magao-x/handbook/index.rst

Instrument Handbook
===================================

.. include:: README.rst

Table of contents
=================

.. toctree::
    :maxdepth: 3

    observers/index
    operating/index
    software/index
    testbed/index
    maintenance/index
    troubleshooting
    handling/index
    compute/index
    appendices/index
