magao-x/handbook/observers/planning.rst

******************************
Planning your observations
******************************

.. toctree::
   :maxdepth: 1

   filters
   cameras
   coronagraphs
