magao-x/handbook/observers/reduction/index.rst

Data reduction and calibration
==============================

Information about reducing MagAO-X data.

.. toctree::
   :maxdepth: 2

   astrometry
   sparkles
