magao-x/handbook/maintenance/electronics/index.rst

Electronics
===================================

Procedures and guidelines for maintenance of MagAO-X electronics.

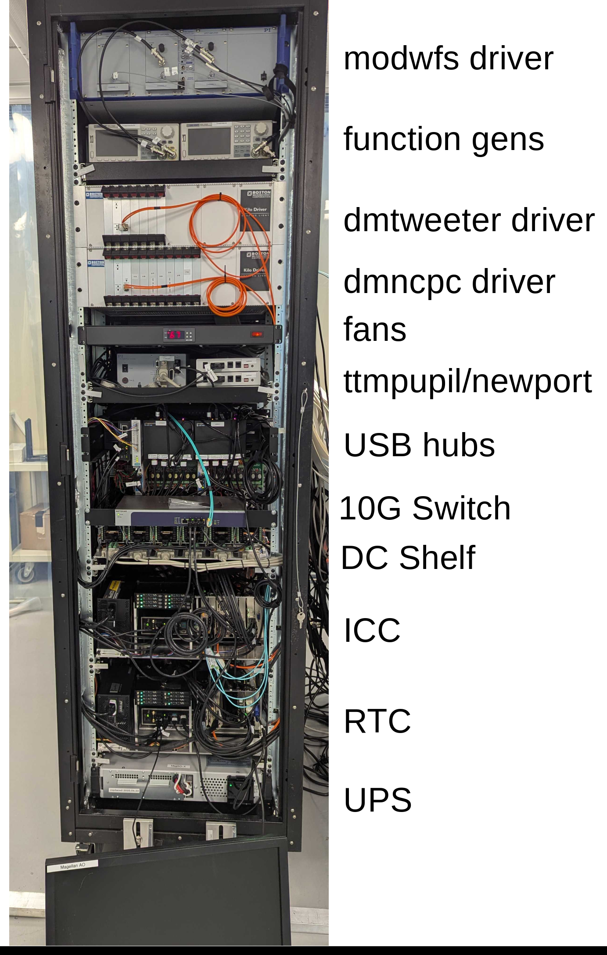
[picture p84: maintenance/electronics/figures/electronics.png]
   

   *The MagAO-X Electronics Rack*

.. toctree::
   :maxdepth: 1

   computers
   zaber_stages
