magao-x/handbook/compute/example_power_gui.png

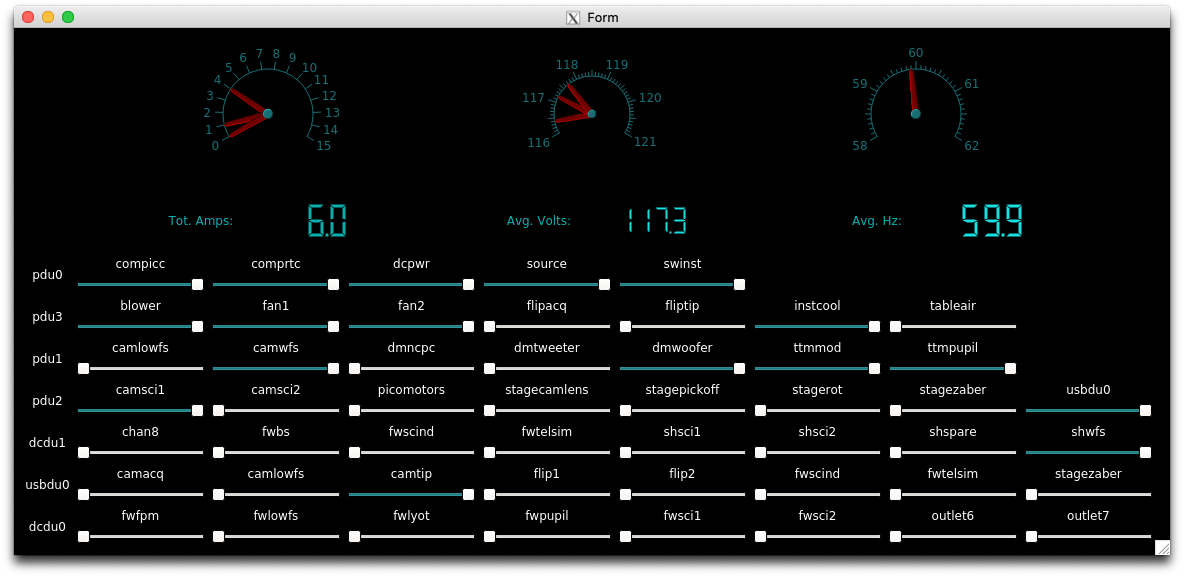
compute/example_power_gui.png
