magao-x/handbook/handling/figures/air_receiver_drier.jpeg

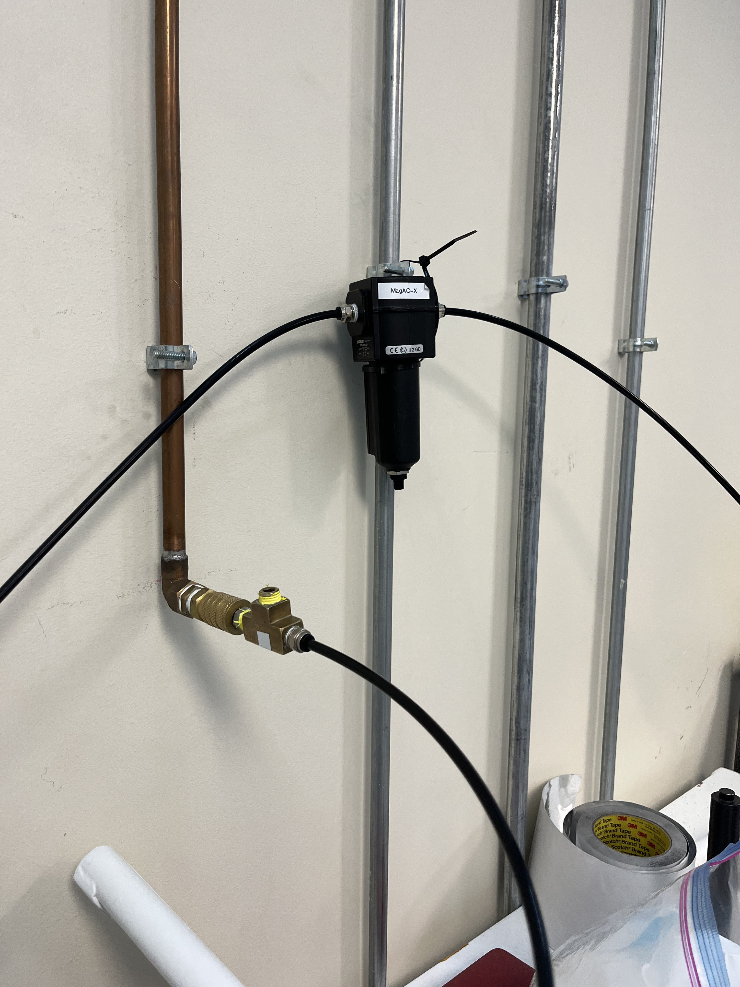
handling/figures/air_receiver_drier.jpeg
