magao-x/handbook/handling/figures/bmc_samtec_insert.jpg

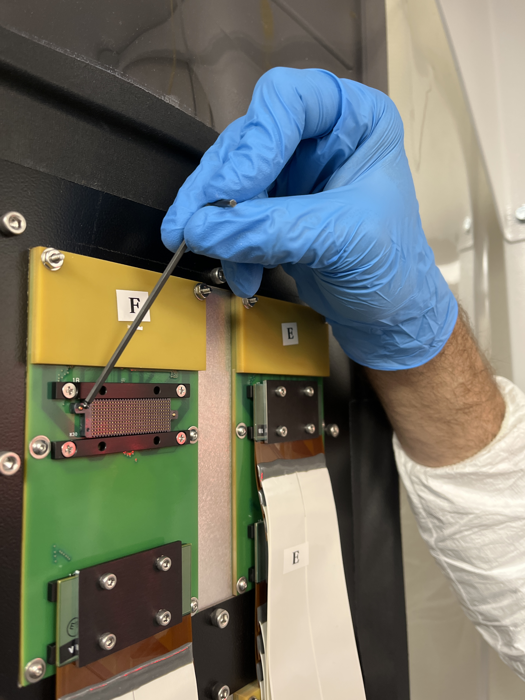
handling/figures/bmc_samtec_insert.jpg
