magao-x/handbook/maintenance/electronics/figures/erack_input_side_open.jpg

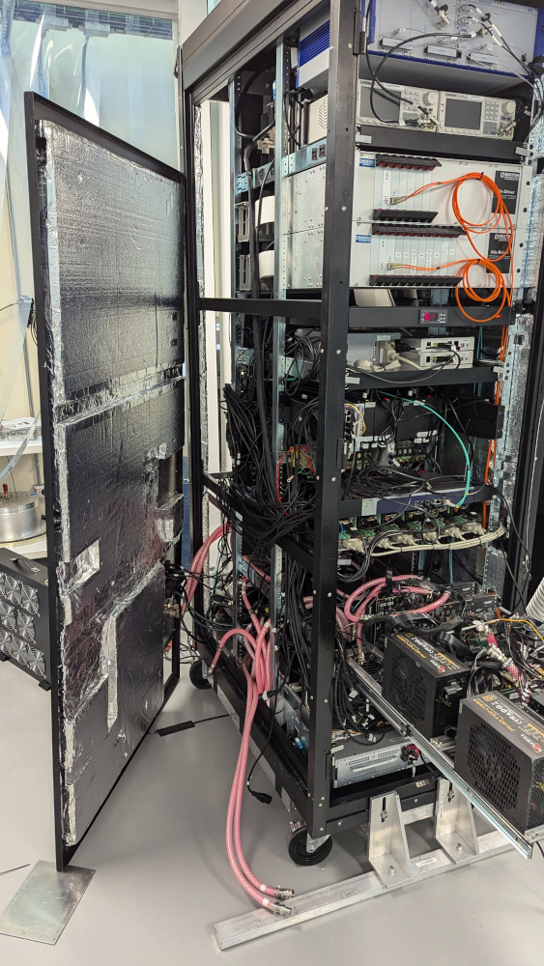
maintenance/electronics/figures/erack_input_side_open.jpg
