magao-x/handbook/handling/figures/air_components_stowed.jpeg

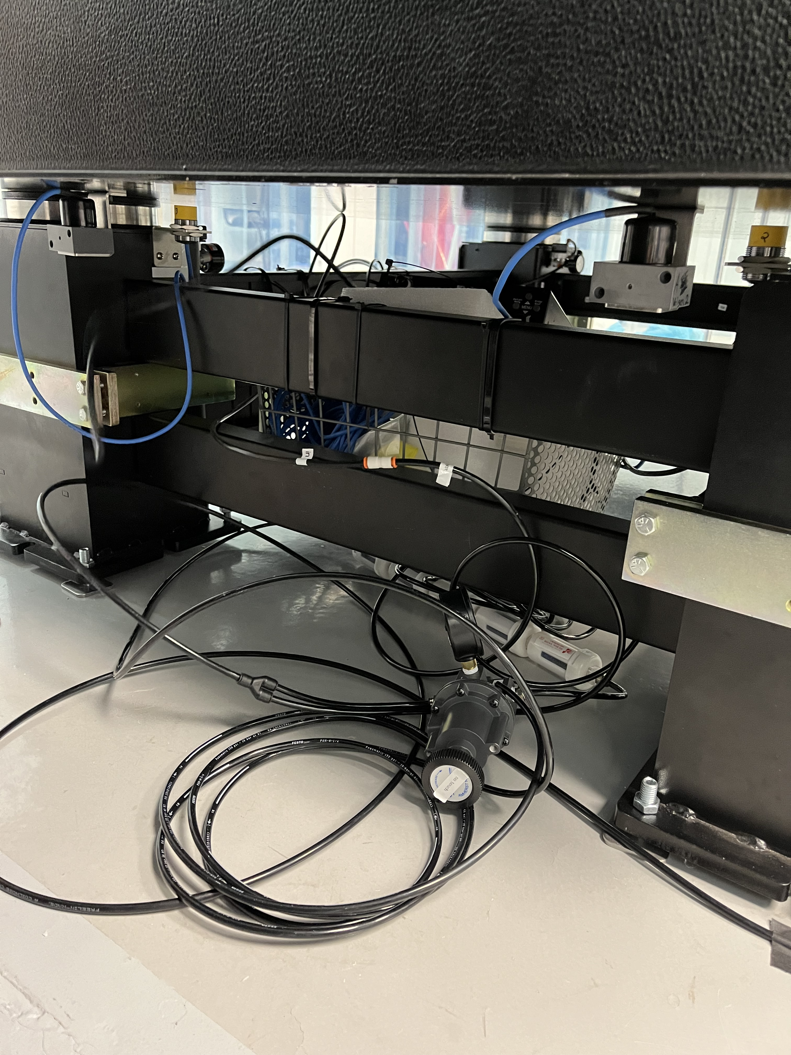
handling/figures/air_components_stowed.jpeg
