magao-x/handbook/handling/figures/components_basket.jpeg

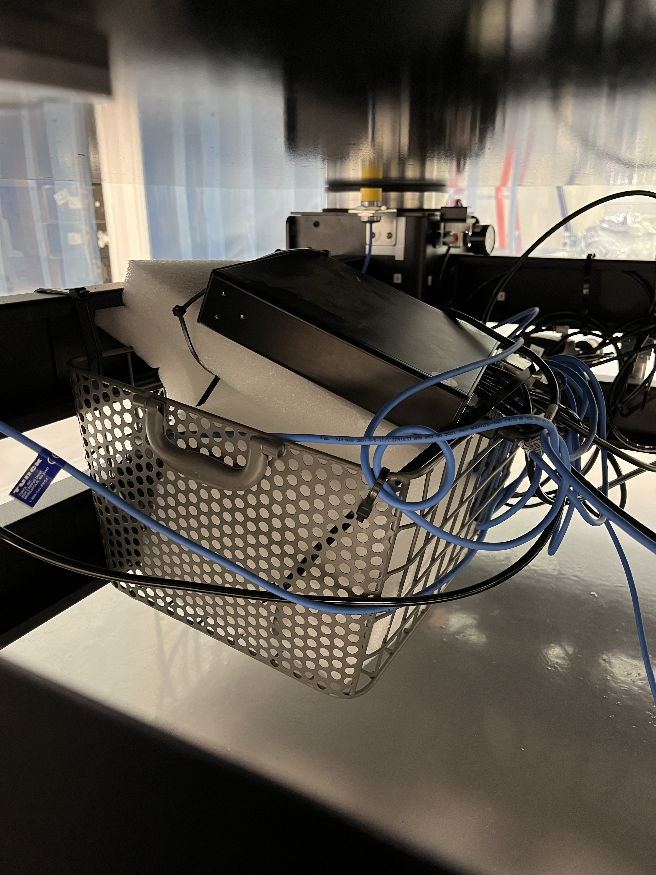
handling/figures/components_basket.jpeg
