magao-x/handbook/_static/coronagraph/lyot/LyotStop_small.DXF

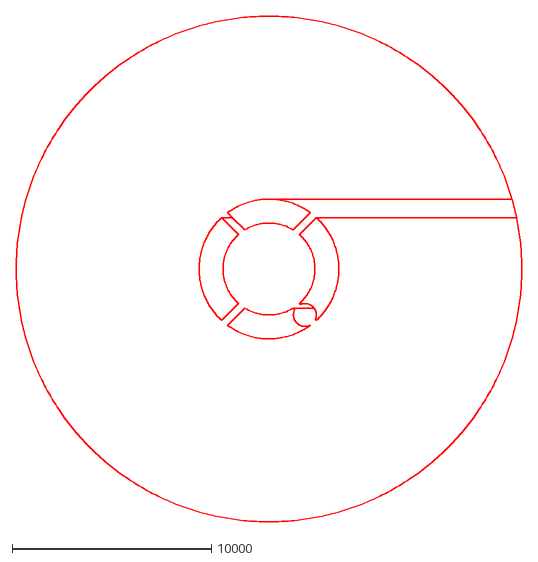
[picture p96: CAD file, 2024-01-09]
_static/coronagraph/lyot/LyotStop_small.DXF
25400.2 x 25400.2
