magao-x/handbook/_static/coronagraph/lyot/LyotStop_large1.DXF

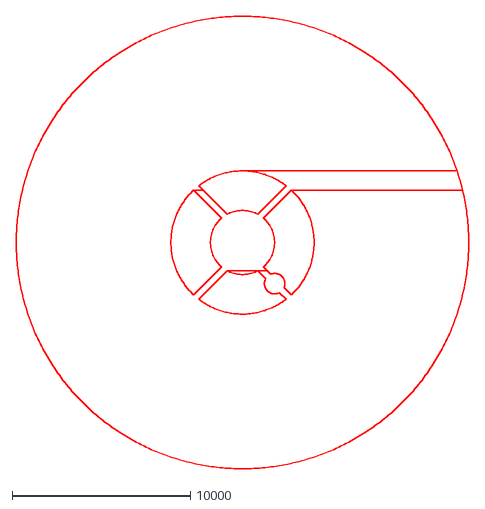
[picture p97: CAD file, 2024-01-09]
_static/coronagraph/lyot/LyotStop_large1.DXF
25400.2 x 25400.2
