magao-x/handbook/_static/coronagraph/lyot/LyotStop_large2.DXF

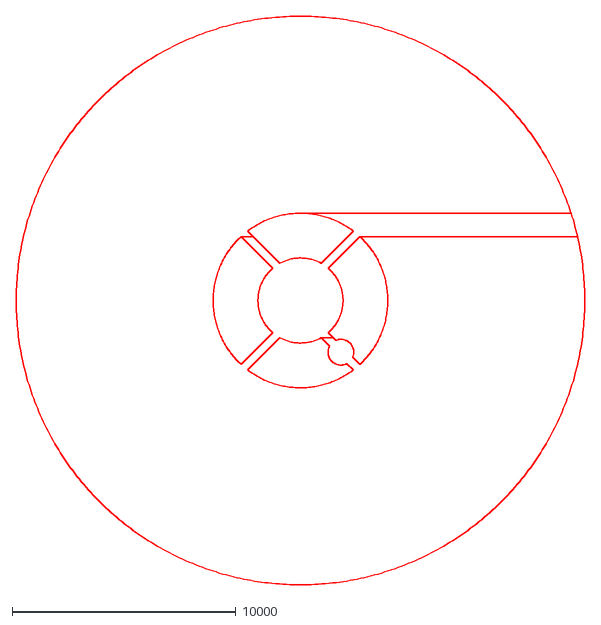
[picture p98: CAD file, 2024-01-09]
_static/coronagraph/lyot/LyotStop_large2.DXF
25400.2 x 25400.2
