magao-x/handbook/operating/block_diagram.rst

Functional Block Diagram
========================

**Updated April 3, 2026**

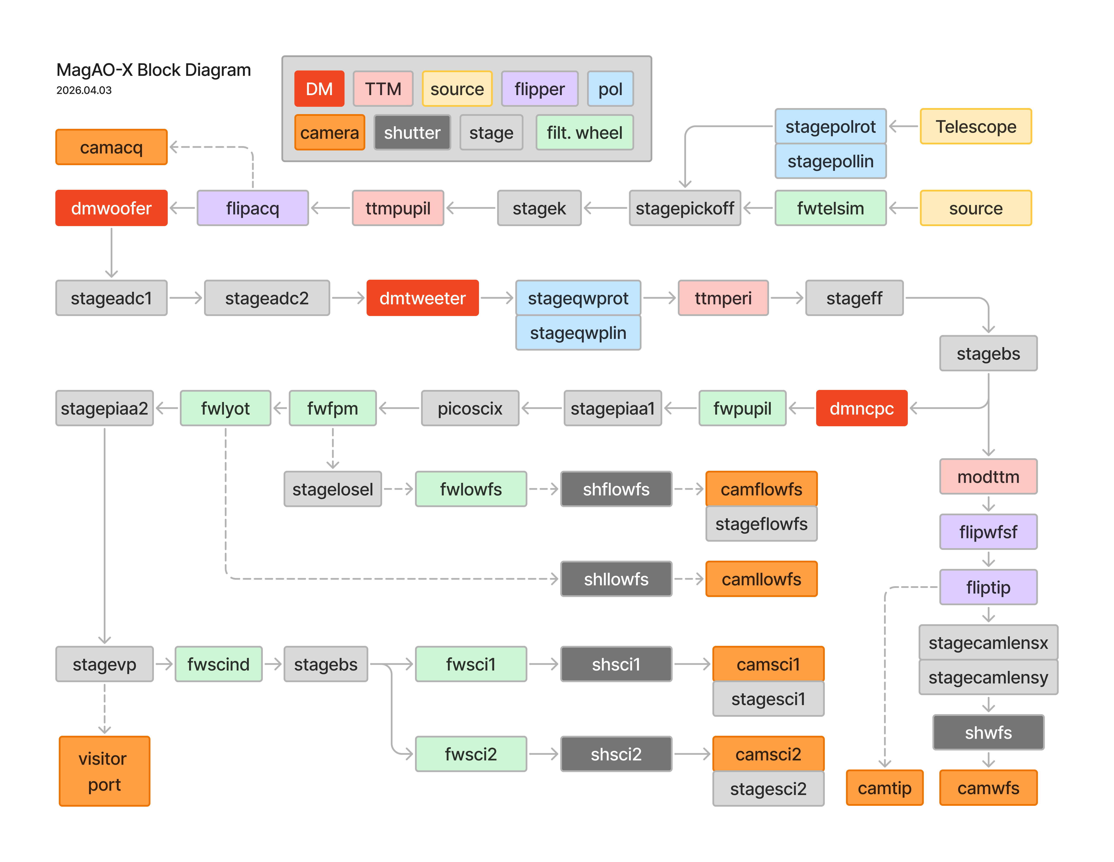
[picture p99: operating/figures/magaox_functionalBlockDiagram_20260403.png]
Block diagram for MagAO-X


Changelog
---------

2026A - update 2026-04-03
^^^^^^^^^^^^^^^^^^^^^^^^^

- Visitor port stage has changed from `visport` to `stagevp`.
- Quarter wave plate rotator `stageqwprot` and linear stage `stageqwplin` installed.
