magao-x/handbook/operating/software/apps/index.rst

Applications
============

.. toctree::
    :maxdepth: 2

    overview
    cameras
    dms
    filters
    zaber
    network
    power
