magao-x/handbook/operating/software/guis/web_gui.rst

Web GUI
========

Open http://localhost:9191/ (or tunnel it to your computer from AOC) to
use the web UI for filter wheels, stage positions, streamwriter and
shutter toggles, etc.
