magao-x/handbook/operating/software/guis/index.rst

GUIs & TUIs
============

.. toctree::
    :maxdepth: 2
    
    cursesINDI
    web_gui
    cameras
