magao-x/handbook/handling/figures/cart_lift_guide_pin.jpg

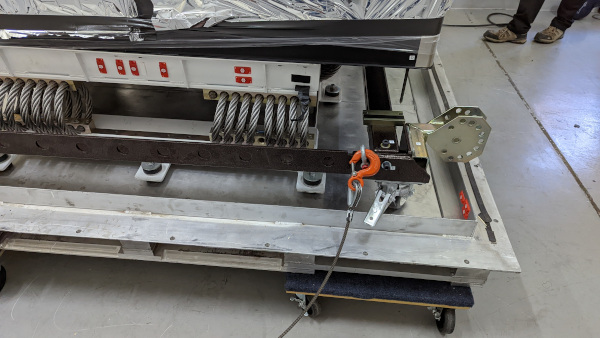
handling/figures/cart_lift_guide_pin.jpg
