magao-x/handbook/operating/bump-mask_aligned.png

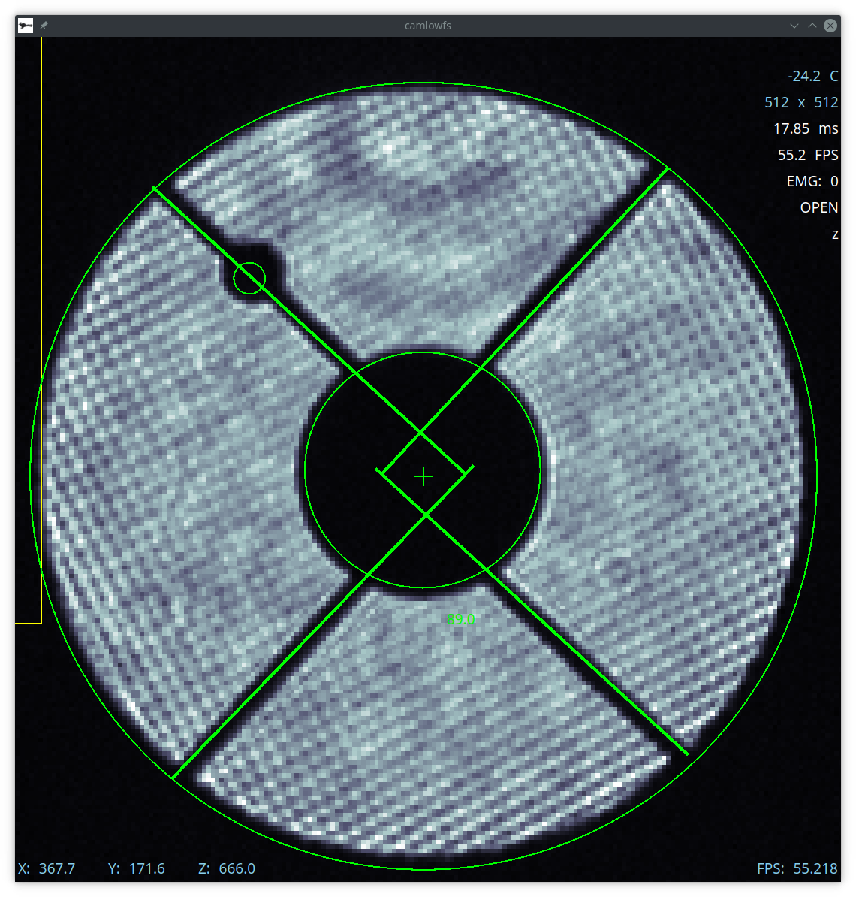
operating/bump-mask_aligned.png
