magao-x/handbook/operating/camlowfs_tgt.png

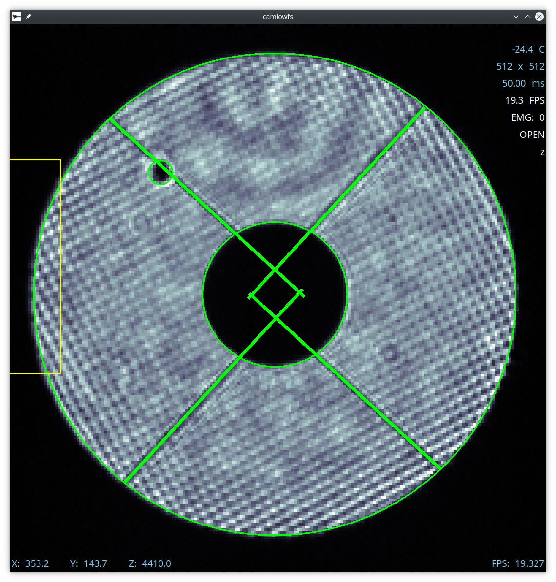
operating/camlowfs_tgt.png
