magao-x/handbook/operating/figures/magaox_functionalBlockDiagram_20251129.png

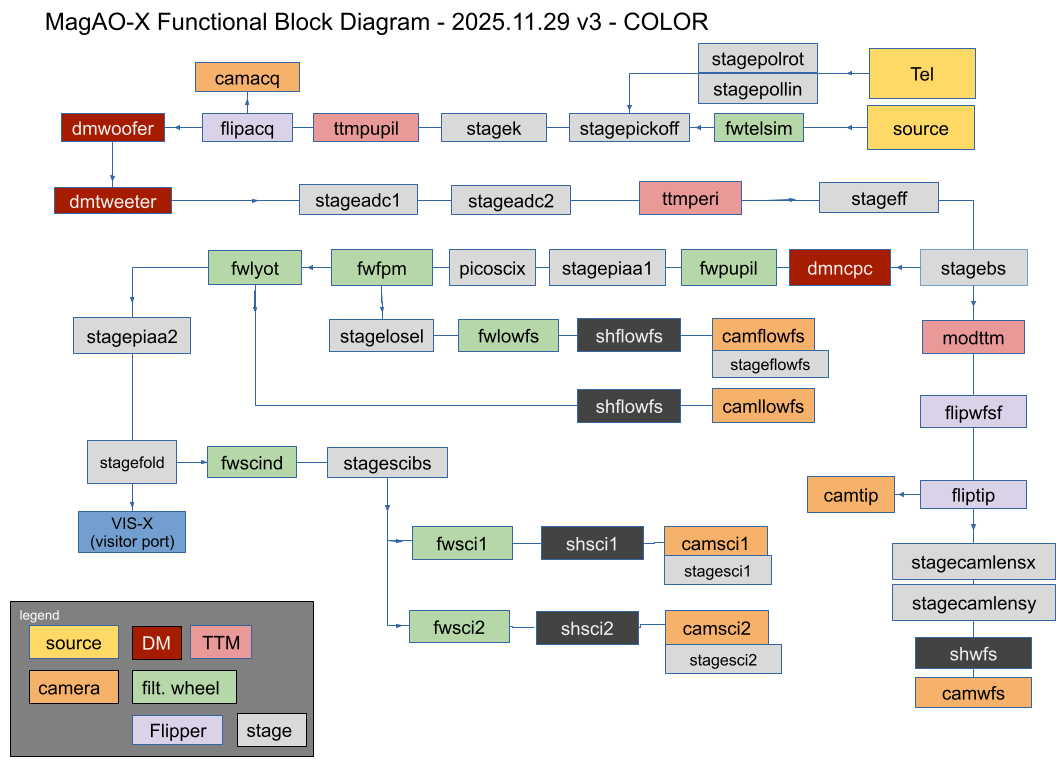
operating/figures/magaox_functionalBlockDiagram_20251129.png
