magao-x/handbook/operating/figures/obslog_start_feed.png

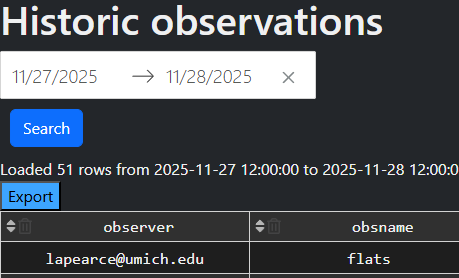
operating/figures/obslog_start_feed.png
