magao-x/handbook/operating/figures/PIAA_Lyot_stop_aligned.png

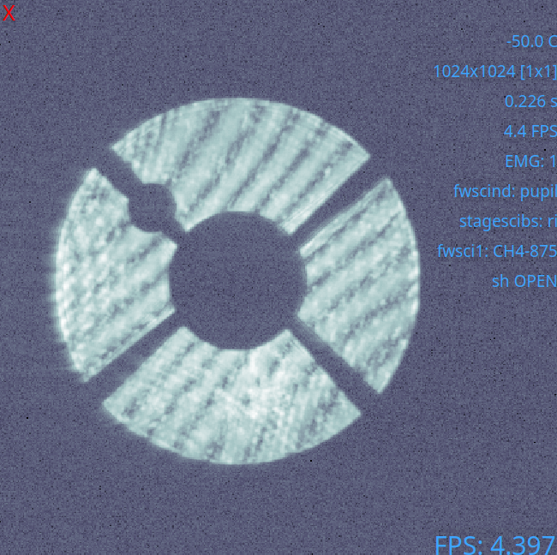
operating/figures/PIAA_Lyot_stop_aligned.png
