magao-x/handbook/operating/fpm_aligned_post_eye-doctor.png

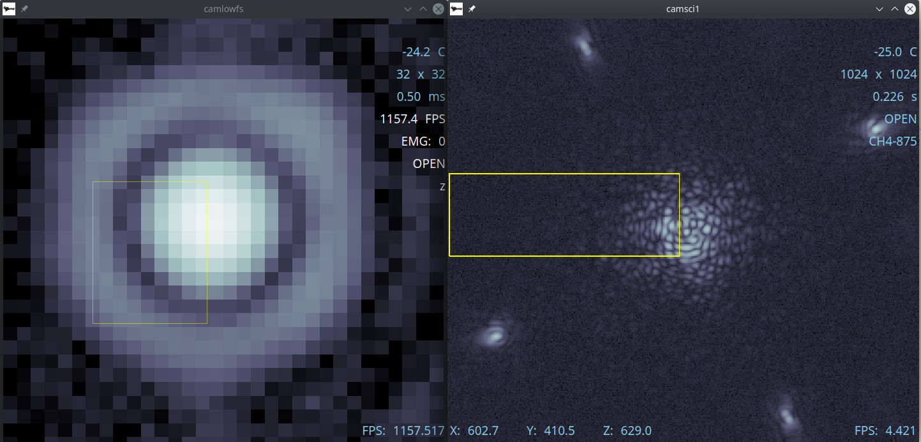
operating/fpm_aligned_post_eye-doctor.png
