magao-x/handbook/operating/fpm_aligned_pre_eye-doctor.png

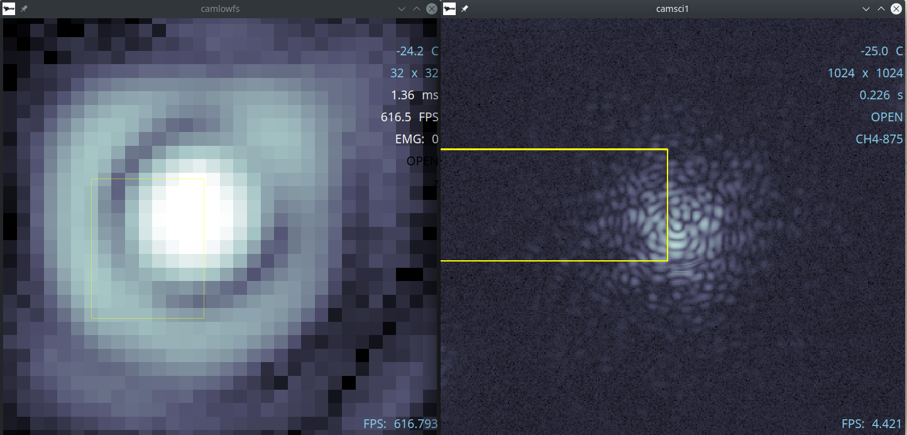
operating/fpm_aligned_pre_eye-doctor.png
