magao-x/handbook/operating/fwlyot_lyotlg1_aligned.png

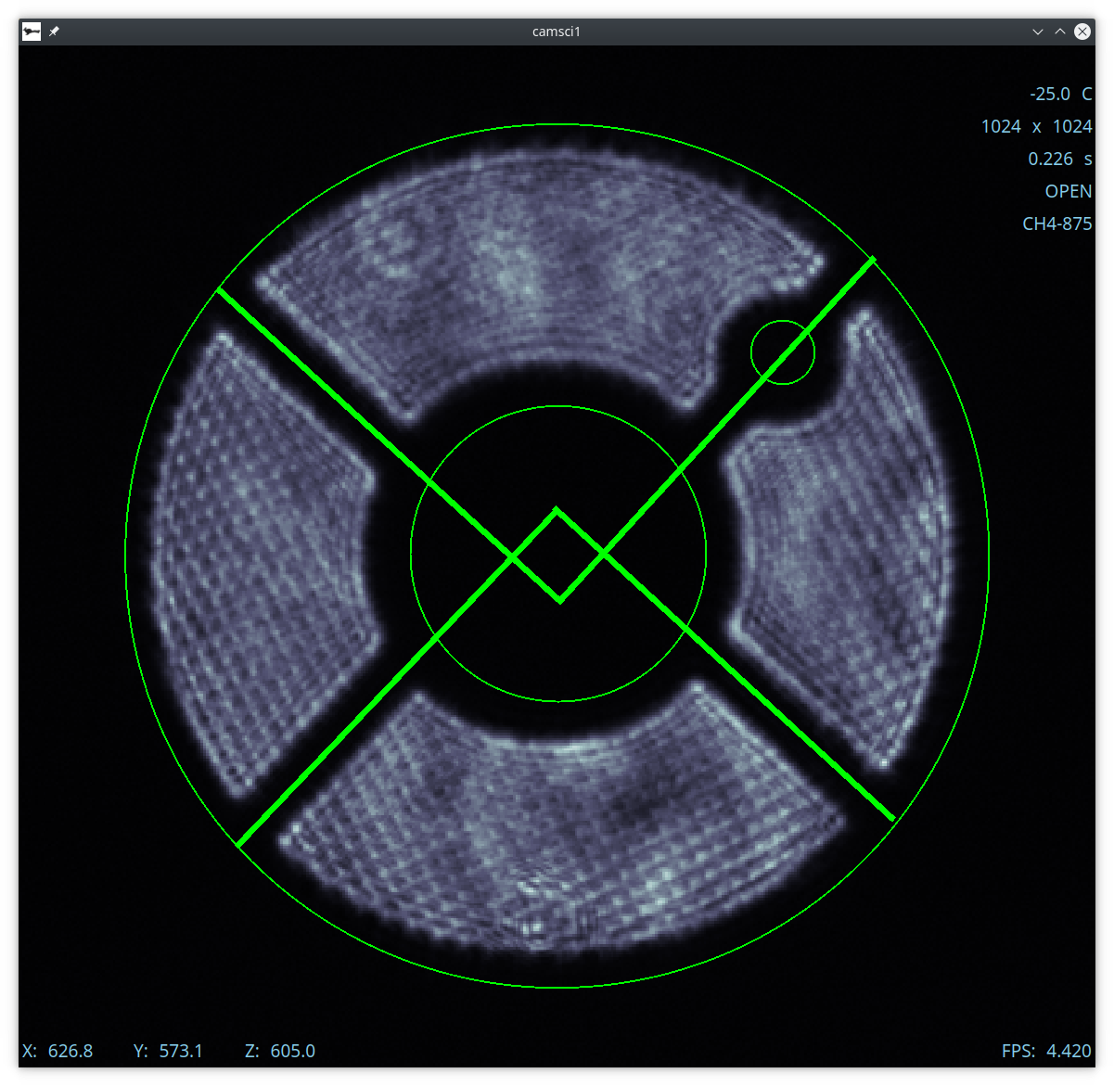
operating/fwlyot_lyotlg1_aligned.png
