magao-x/handbook/operating/rtc_save_and_exit_yes.png

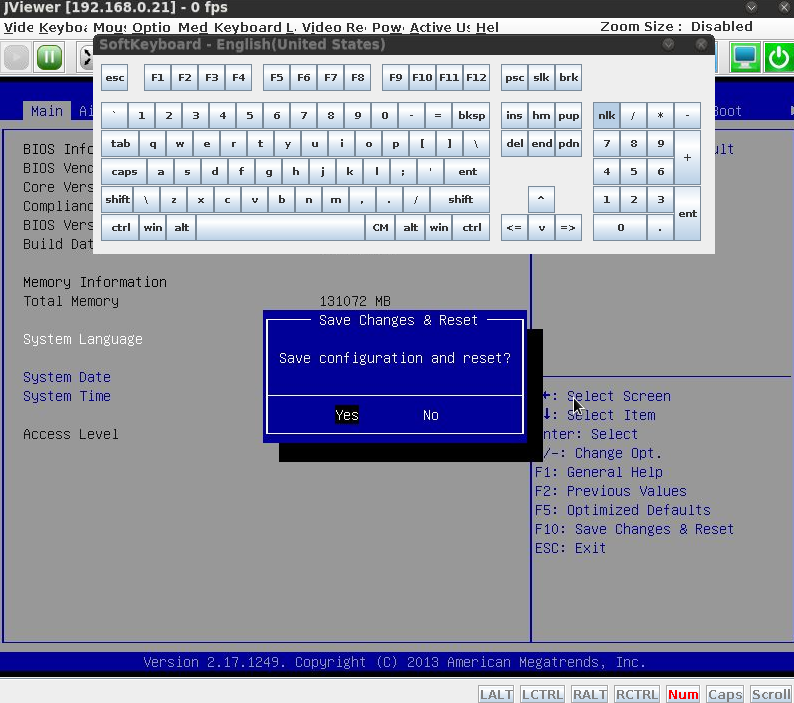
operating/rtc_save_and_exit_yes.png
