magao-x/handbook/maintenance/cooling/measuring_glycol_freezing_point.rst

Measurement of coolant freezing point
==========================================================================

We have and an Extech R41 model refractometer in the MagAO-X "Cooling system parts, tools, and hardware" box in the cleanroom.
It is in a black semi-hardshell case about the size of an eyeglasses case.

Usage
----------

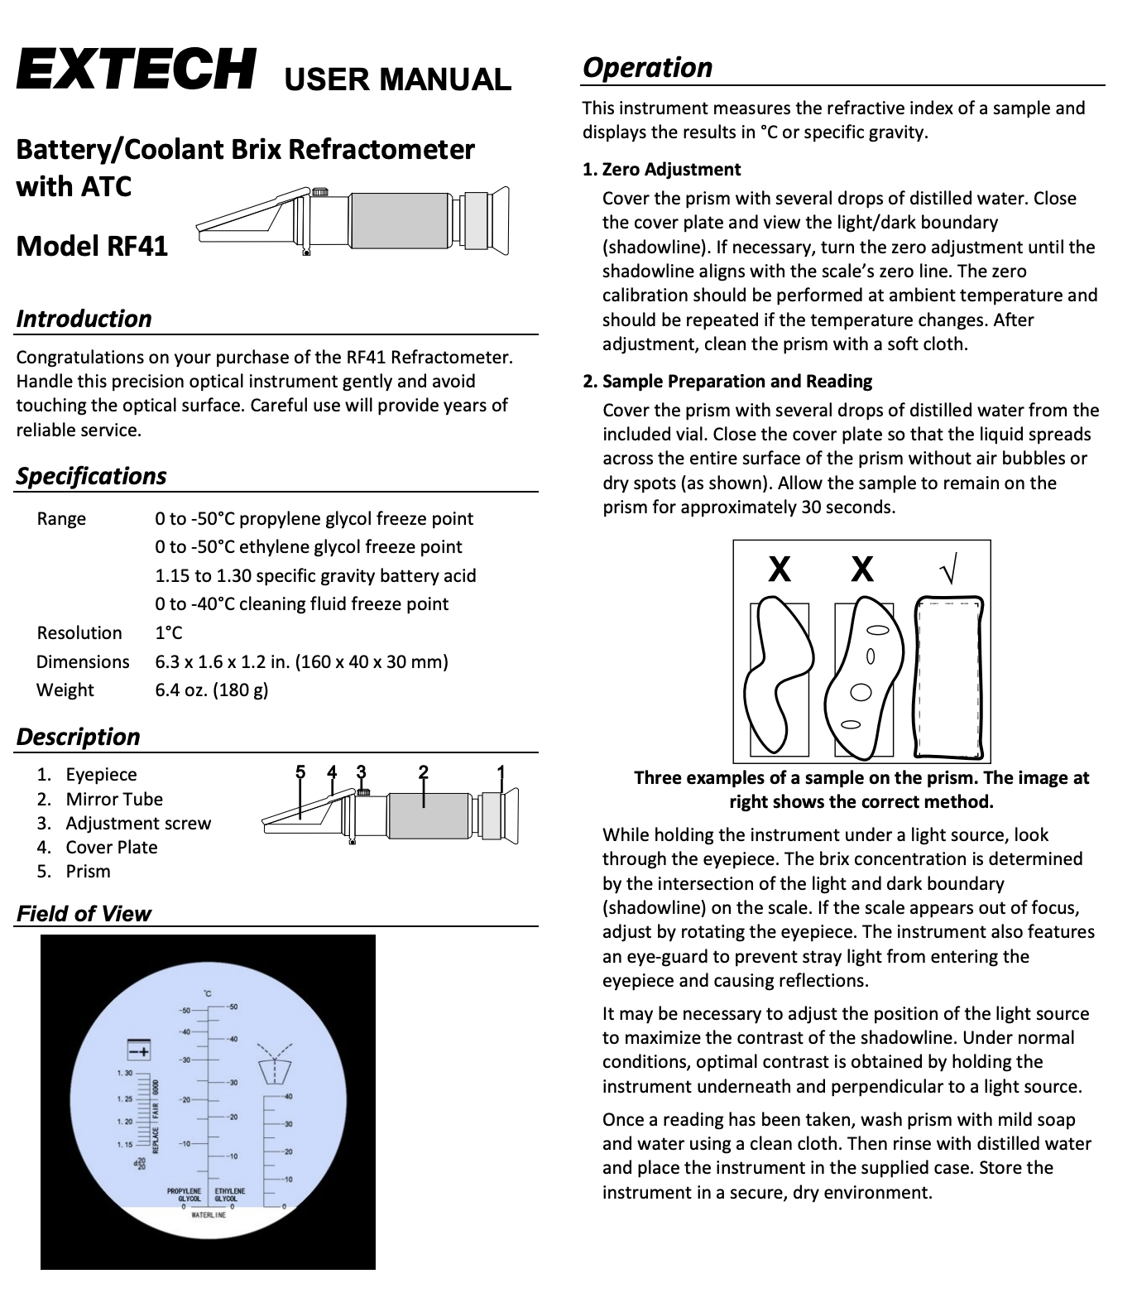
[picture p154: maintenance/cooling/figures/ExtechR41_refractometer_UserManual.png]


Latest measurements
------------------------

On 2026-03-21 we measured the MagAO-X instrument glycol concentration using the refractometer and found a freezing point of about -22 Celsius.

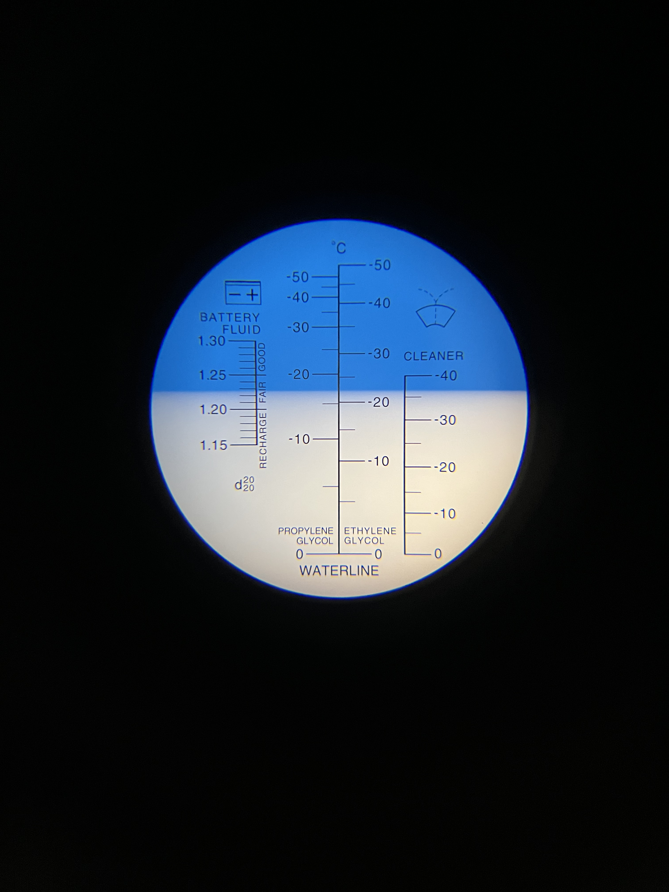
[picture p155: maintenance/cooling/figures/ethylene_glycol_refractometer_20260321.jpeg]
