magao-x/handbook/maintenance/cooling/index.rst

Liquid Cooling
===================================

The instrument cooling system cools the cameras, computer CPUs and GPUs.  Facility glycol cools the instrument
cooling system (liquid to liquid heat exchanger) and the rack air heat exchanger to remove heat from the rack.

   

   *Instrument cooling system*

Maintenance
---------------

Procedures and guidelines for maintenance of MagAO-X liquid cooling systems.

.. toctree::
   :maxdepth: 1

   filter_cleaning
   system_backflush
   measuring_glycol_freezing_point
