magao-x/handbook/maintenance/index.rst

Maintenance
======================================

Procedures and guidelines for maintenance of MagAO-X systems.

.. toctree::
   :maxdepth: 2

   cooling/index
   electronics/index
