magao-x/handbook/(threads)

Thread 9 (2019-12-01):

Cleanroom to Magellan procedure revisions

joseph-long, 2019-12-01:

joseph-long, 2019-12-01:
Ordering of adding cart to table: position table under crane before completing the cart, since moving the table legs and cart has a tendency to jam one on the other.

joseph-long, 2019-12-01:
Hook carabiners to cart with open side up (so the cables can reach load spreader)

(Have pic)

joseph-long, 2019-12-01:
More long handled large Allen keys to parallelize cart (dis)assembly

joseph-long, 2019-12-01:
Request additional hook just forward of rear wheel fender

joseph-long, 2019-12-01:
Ordering: legs must reach nasmyth platform before instrument, else instrument would be in the way on platform

joseph-long, 2019-12-01:
Corner clamps B and C are “telescope side” on the table. Note clamp indexing != leg indexing

joseph-long, 2019-12-02:
Table gimbal misalignment upon lowering the table is an issue. Possible solutions include extreme care with crane operation, or maybe lowering by crane onto screw jacks for final lowering by hand

jaredmales, 2024-05-25:
how are we doing on these?

joseph-long, 2024-05-25:
get outta here, everyone knows the procedure now

Closed 2024-05-25.

Thread 18 (2024-05-25):

color transforms

jaredmales, 2024-05-25:
they're too blue

logan-pearce, 2024-08-07:
Added new plots

jaredmales, 2024-08-09:
SDSS plot looks great. Is the Gaia (not GAIA) plot correct?  It looks blue
to me too.

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

logan-pearce, 2024-08-09:
I didn’t redo that one. Will do.

On Thu, Aug 8, 2024 at 5:57 PM Jared R. Males ***@***.***>
wrote:

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

Closed 2024-08-07.
