magao-x/handbook/(commit log)

2020-02-17 Add :static: role for links into _static/ from docs, change filters
2020-02-17 Remove a couple test links left in...
2020-04-03 updated filters
2020-09-10 Add more details to the case of the filled tmpfs
2020-10-10 reorganized startup guide; added complete RTC/ICC power-up procedure; updated RTC lockup troubleshooting
2020-11-23 added camera control docs, and baslerCtrl doc; promoted xctrl to utility
2021-02-26 added camera numbers
2021-10-18 big CACTI update because I'm tired of reincountering undocumented problems with solutions
2022-02-25 add link to actuator functionality notebook
2022-04-15 Update filters.rst
    Added WFS passband and Gaia to WFS color correction plots to filters.rst
2022-09-05 updated filter curves with better atm blue
2022-10-06 updated for de-flipped camscis
2022-11-26 PIAALC schematic, Guyon 2010
2022-11-27 Update coronagraphs.rst
    Revised figures and included 656nm simulations
2022-11-27 Add data and remove old figures
    [coronagraph_contrast_656.csv, coronagraph_contrast_900.csv, coronagraph_throughput_656.csv, coronagraph_throughput_900.csv]
2022-11-28 Add speckle noise plots and update simulation BW
    [coronagraph_contrast_656.csv, coronagraph_contrast_900.csv, coronagraph_throughput_656.csv, coronagraph_throughput_900.csv]
2022-11-30 Update plots based on revised PIAA grid diameter
    [coronagraph_contrast_656.csv, coronagraph_contrast_900.csv, coronagraph_throughput_656.csv, coronagraph_throughput_900.csv]
2023-02-24 added CH4 filters to power down for transport
2023-05-25 udpated startup pro for current steps
2023-10-22 added mobo battery to tshoot
2023-12-21 Adding a new Python INDI device docs
2024-01-09 updated Lyot stop params
    [LyotStop_large1.DXF, LyotStop_large2.DXF, LyotStop_small.DXF]
2024-01-14 Describe text logging for Python devices
2024-03-04 Add instructions to mount home into the vm, which was automatic until we started naming it. Minor clarifications.
2024-05-11 New figures for table legs and PEPS II setup
2024-05-11 Created table air setup doc
    New procedure documentation for getting the legs and air system set up in the clean room. Will add notes for telescope install later.
2024-08-04 added legs/air setup to toc and fixed caption
2024-08-11 added maintenance section, filter cleaning procedure, and USB troubleshooting
2024-08-14 Replaced MagAOX vs SDSS filter curves
2024-08-14 Updated MagAO-X to SDSS color conversion csv
    [MagAOXfilters_toSDSSfilters_color_conversion.csv]
2024-08-14 Replaced Gaia G to MagAOX WFS color conversion csv
    [GaiaG_WFS_color_conversion.csv]
2024-08-19 add documentation for installing magaox on a raspberry pi and installing required software for windows
2024-09-19 updated glycol filter reqs
2024-11-11 Update daily_shutdown.rst
    Added camvisx to the camera shutdown procedures.
2024-11-17 Update cacao.rst
    Added the new adjustable parameters to flowfs troubleshooting.
2024-11-23 Expand actuator functionality test
2024-12-30 Update remote_operation.rst
    Updated for current process, and added link to script for unattended setup.
2025-03-20 Add warnings to cameras
2025-10-08 fixed formatting and added instr to reinstall current version
2025-11-24 Update system_backflush.rst
    Add step to check flow rate prior to backflushing.
2025-11-26 added zaber stage maintenance info
2026-01-26 added zaber homing instructions
2026-01-27 Update daily_startup.rst with zaber homing
2026-03-21 Add flowfs centering alignment update, add initial auto alignment caveats
2026-03-23 add 'sensors-detect' to computer setup docs
2026-03-23 Remove flowfs alignment warning, add checks to auto align
2026-03-25 Update sensor probing docs
