magao-x/handbook/handling/figures/bmc_taped_esd_bag.jpg

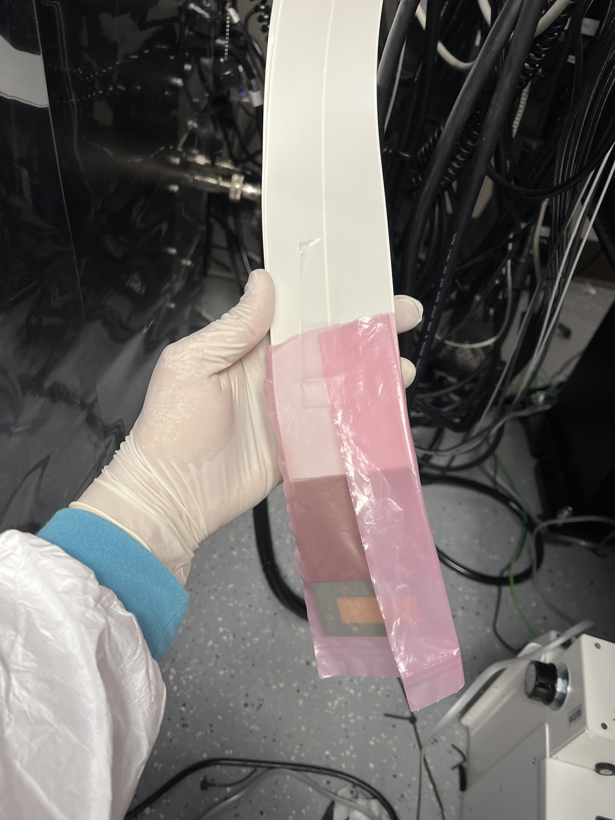
[picture p18: handling/figures/bmc_taped_esd_bag.jpg]
handling/figures/bmc_taped_esd_bag.jpg
