magao-x/handbook/handling/figures/bmc_bagged_cables.jpg

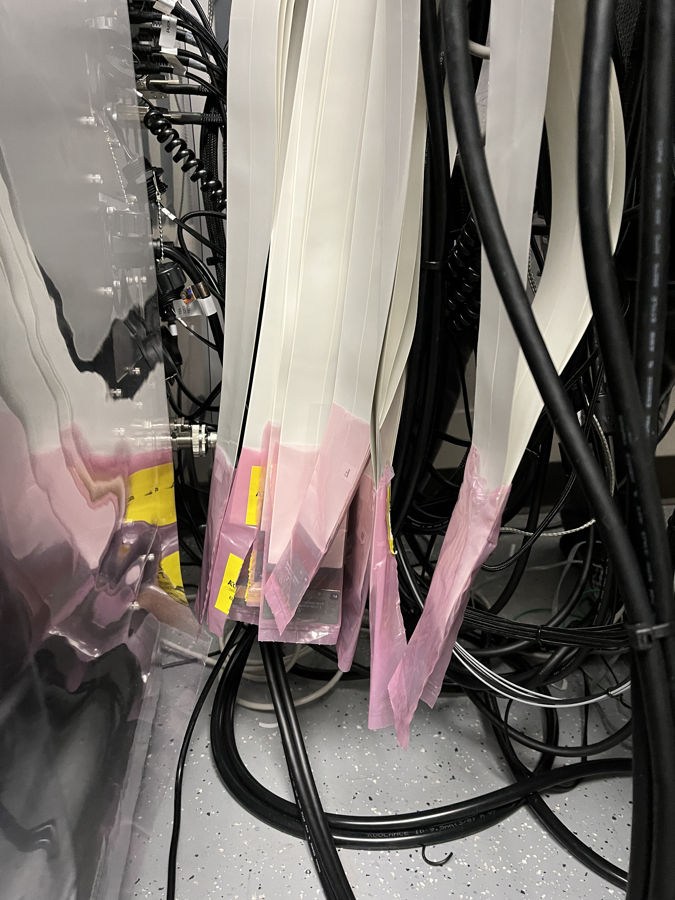
[picture p19: handling/figures/bmc_bagged_cables.jpg]
handling/figures/bmc_bagged_cables.jpg
