magao-x/handbook/handling/figures/bmc_letter_large.jpg

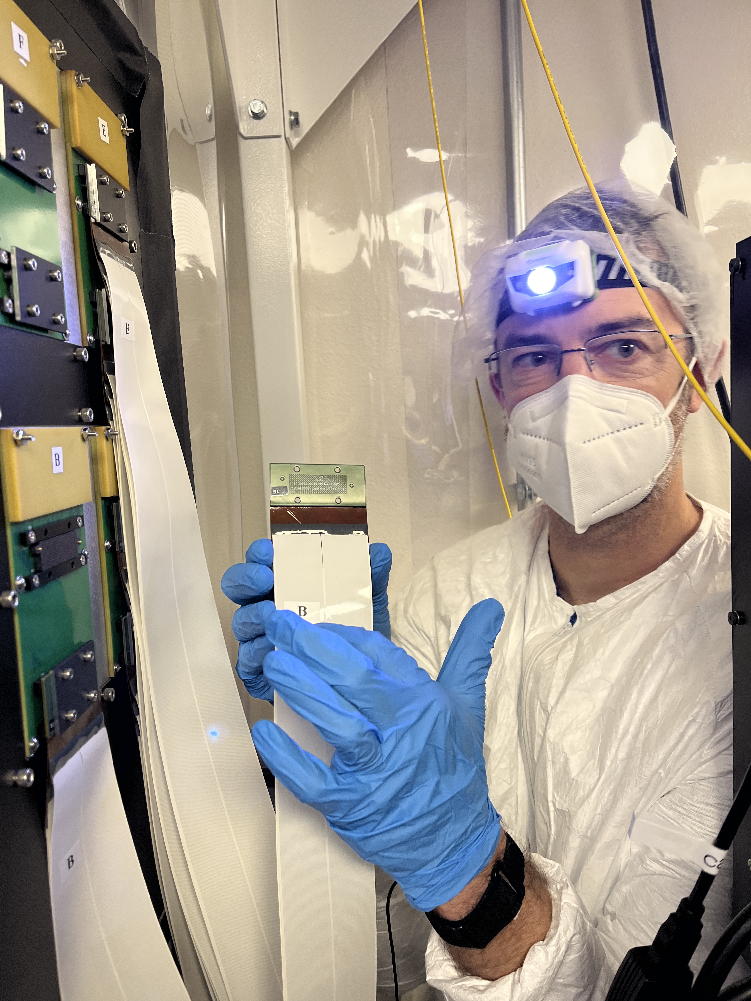
[picture p21: handling/figures/bmc_letter_large.jpg]
handling/figures/bmc_letter_large.jpg
