magao-x/handbook/handling/figures/bmc_letter_small_cable.jpg

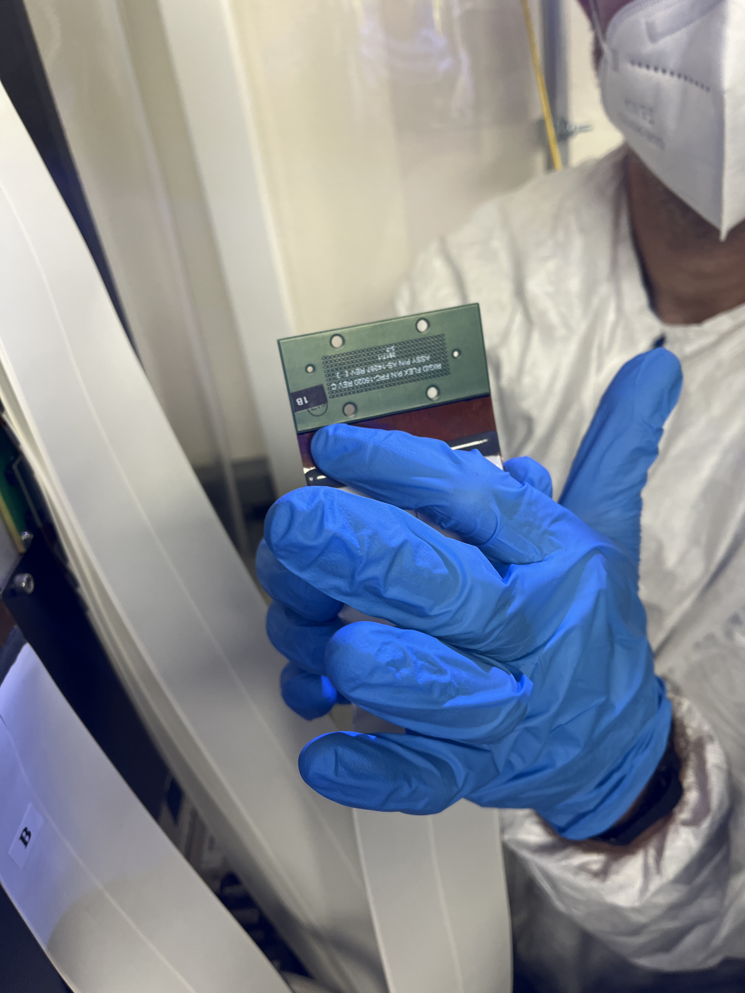
[picture p22: handling/figures/bmc_letter_small_cable.jpg]
handling/figures/bmc_letter_small_cable.jpg
