magao-x/handbook/maintenance/cooling/figures/cpu_gpu_cooling.jpeg

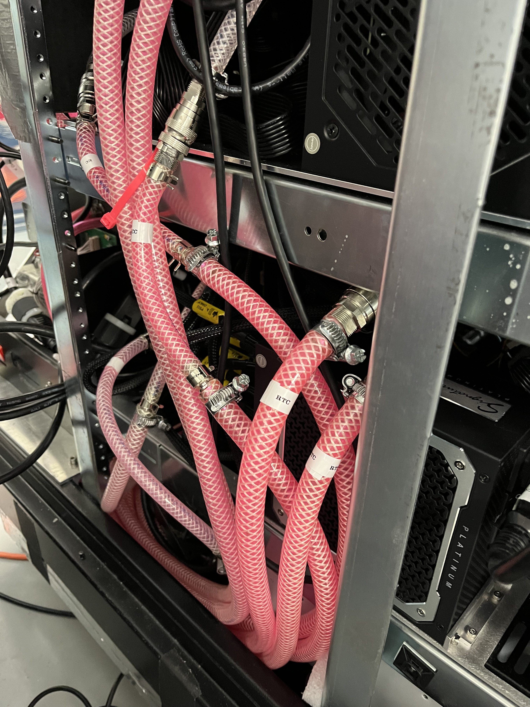
[picture p156: maintenance/cooling/figures/cpu_gpu_cooling.jpeg]
maintenance/cooling/figures/cpu_gpu_cooling.jpeg
