magao-x/handbook/maintenance/cooling/figures/backflush_jigs_new.jpeg

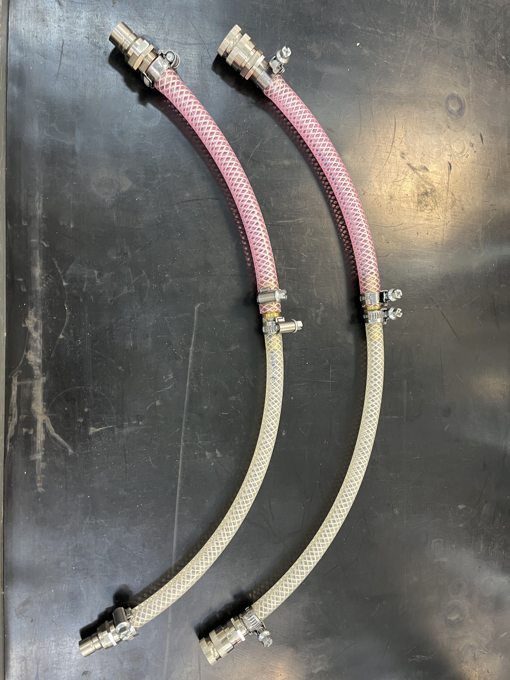
[picture p158: maintenance/cooling/figures/backflush_jigs_new.jpeg]
maintenance/cooling/figures/backflush_jigs_new.jpeg
